tantantheman/tantan-montyball/montyball-photos/montyball-8.jpg

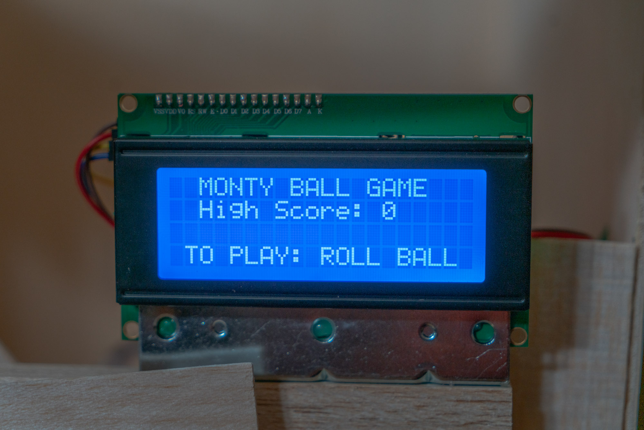
montyball-photos/montyball-8.jpg
