tantantheman/tantan-montyball/montyball-photos/montyball-14.jpg

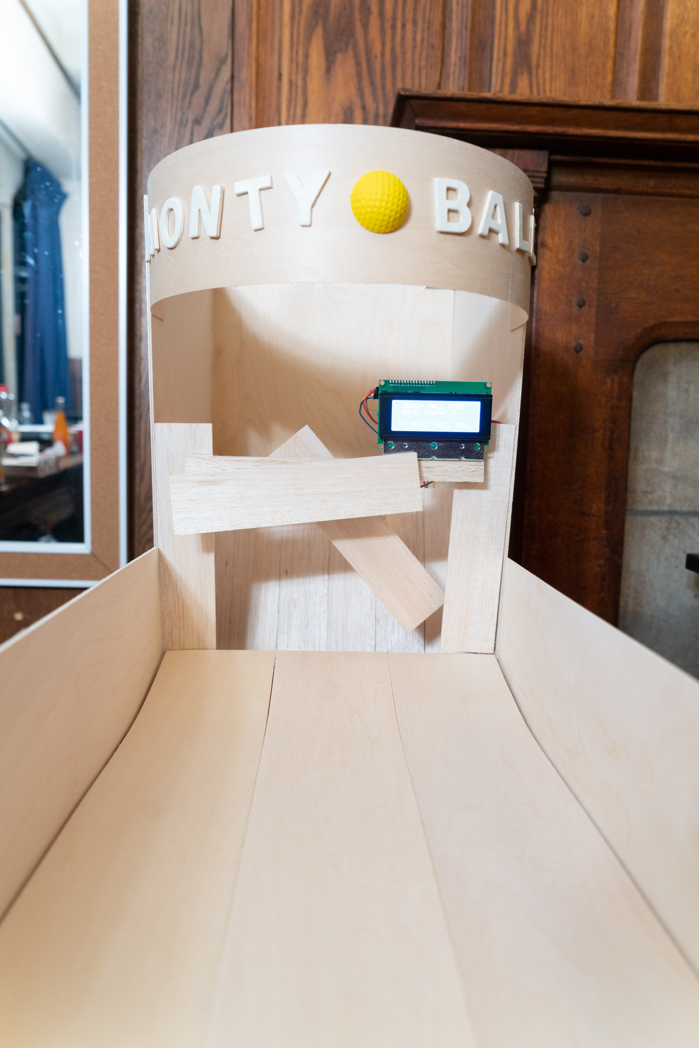
montyball-photos/montyball-14.jpg
