tantantheman/tantan-montyball/montyball-photos/montyball-16.jpg

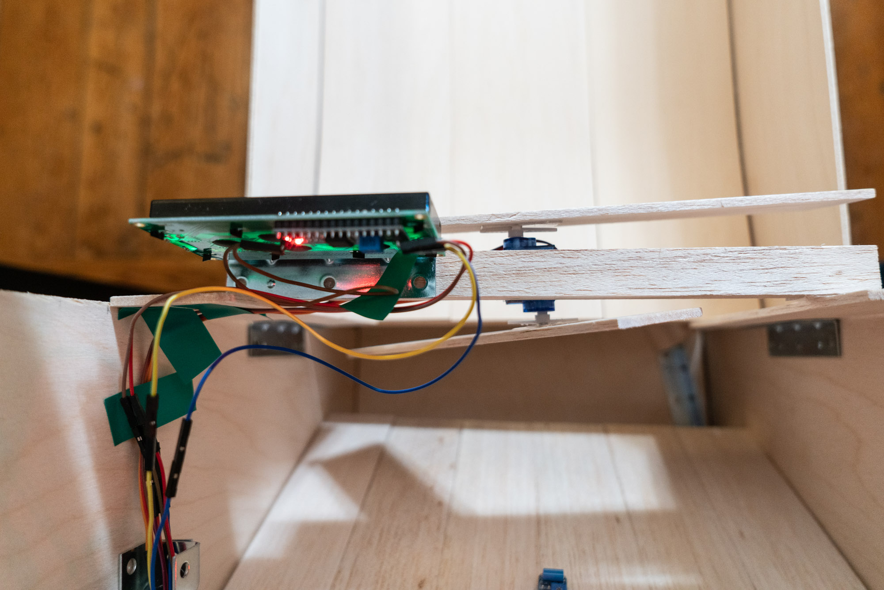
montyball-photos/montyball-16.jpg
