tantantheman/tantan-montyball/lcdtest/lcdtest.ino

/*****************************************
 * name: I2C LCD2004
 * function: You should now see your I2C LCD2004 display "Hello,world!","IIC/I2C LCD2004"
 * "20 cols, 4 rows","www.sunfounder.com"
 ********************************/
//Email:service@sunfounder.com
//Website:www.sunfounder.com

/********************************/
// include the library code
#include <Wire.h> 
#include <LiquidCrystal_I2C.h>
LiquidCrystal_I2C lcd(0x27,20,4);  // set the LCD address to 0x27 for a 16 chars and 2 line display
/*********************************************************/
void setup()
{
  lcd.init();  //initialize the lcd
  lcd.backlight();  //open the backlight 
   
  
  lcd.setCursor ( 0, 0 );            // go to the top left corner
  lcd.print("    Hello,world!    "); // write this string on the top row
  lcd.setCursor ( 0, 1 );            // go to the 2nd row
  lcd.print("  PEE IS STORED IN  "); // pad string with spaces for centering
  lcd.setCursor ( 0, 2 );            // go to the third row
  lcd.print("     THE BALLS      "); // pad with spaces for centering
  lcd.setCursor ( 0, 3 );            // go to the fourth row
  lcd.print("   tantanwang.com   ");
}
/*********************************************************/
void loop() 
{

}
