tantantheman/tantan-montyball/(commit log)

2019-12-12 servos working, new vibration sensor and game over mechanic
    [montyball.ino]
2019-12-12 still need to fix digit bug and flickering
    [montyball.ino]
2019-12-17 more insertions in text
